liammchugh/HOPE_DECAL/COFFEE_MAKER/project submission files/HOPE Design Review Slides-Coffee Bean Roaster.pdf

# Coffee Bean Roaster

Carlson Jansen
Andrew Liu
Mirwais Lodin
Liam McHugh

## Project Overview and Name ~1 min

- Our project aims for implementing a functional precision temperature control for equipment like a Coffee Bean Roaster, by recycling simple popcorn maker with built in heater, fan, and AC power distribution.
- The project will dive into recreating thermocouple module, AC or DC heat fan dimmer/control board, wall plug AC/DC converter, additional app/GUI control on screen display.
- Major challenges would be precise feedback control of temperature in the chamber, additional serial peripheral interface bus may be required if multiple thermocouple is desired.
- ESP32, K-Type Thermocouple, 16x4 LCD
- Overall circuit designs (filter types, power regulator type, power source, microcontroller used, important sensors, actuators or ICs, data buses used)

## BOM ~30 sec

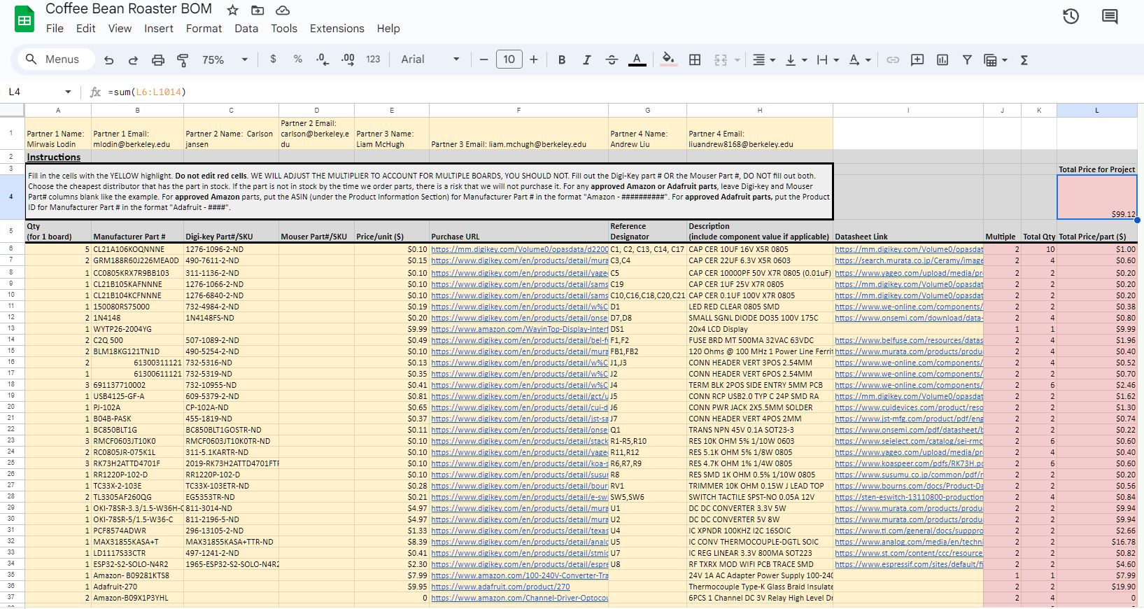
[picture p1: figure]

## Schematic ~2 min

TEMPLATE

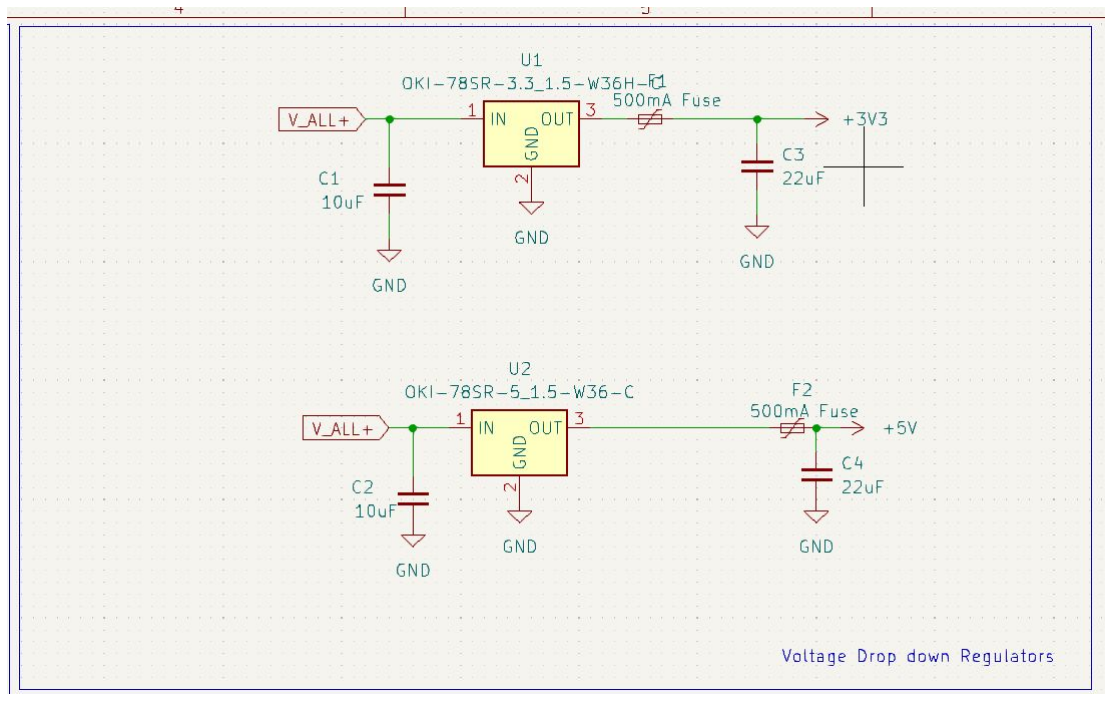
[picture p2: figure]

Voltage drop down module:
DC-DC Converters

24V to 3.3V
24V to 5V

## Schematic ~2 min

TEMPLATE

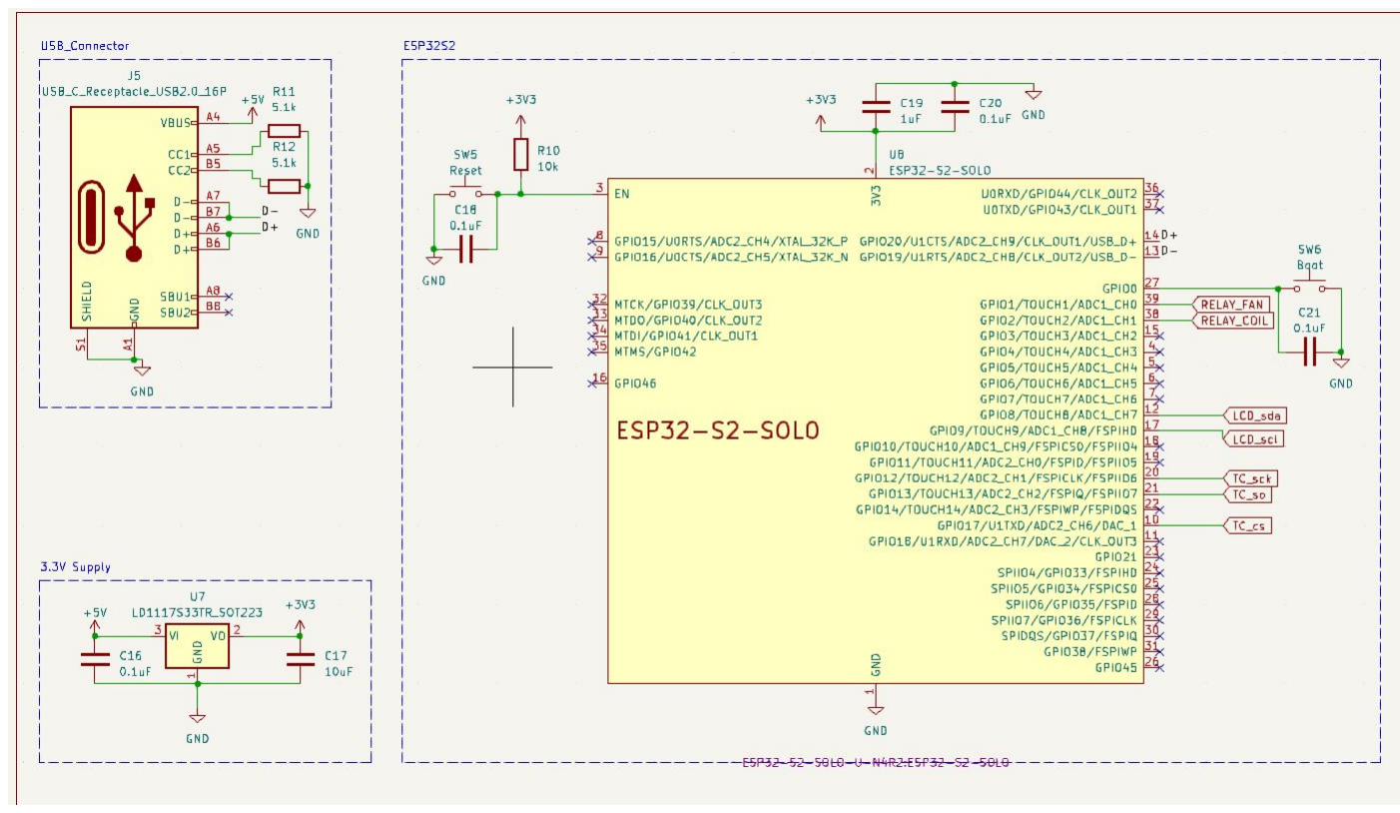
[picture p3: figure]

USB C receptacle

USB Voltage drop down:
-LDO linear Regulator

ESP32-S2-SOLO:
assigned GPIO:
-thermocouple: SO, SCK,CS
-LCD I2C: sda,scl
-Fan relay
-Heater relay
-Boot button
-Reset button

## Schematic ~2 min

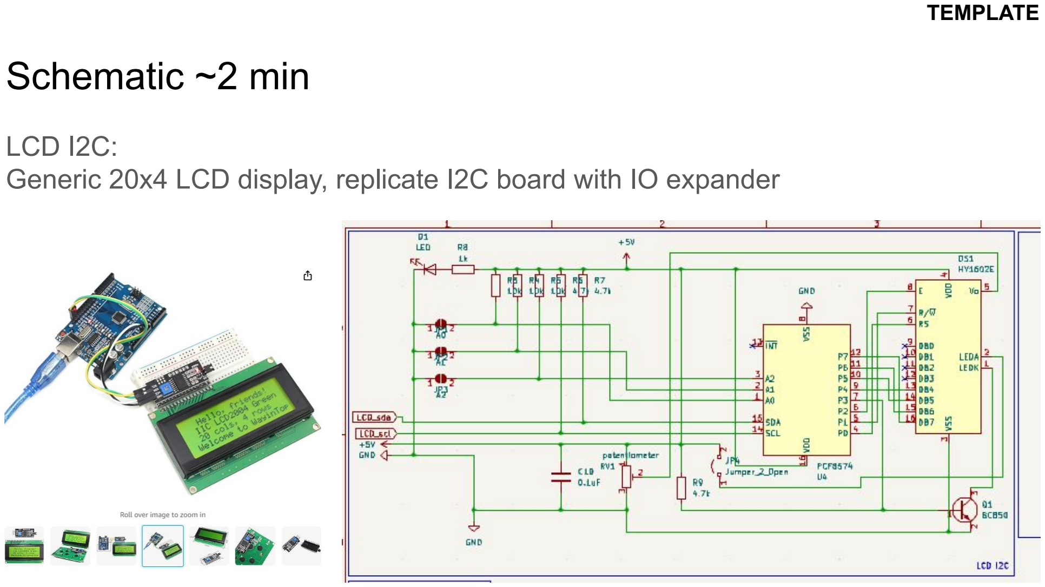
[picture p4: page 6]

TEMPLATE

LCD I2C:
Generic 20x4 LCD display, replicate I2C board with IO expander

## Schematic ~2 min

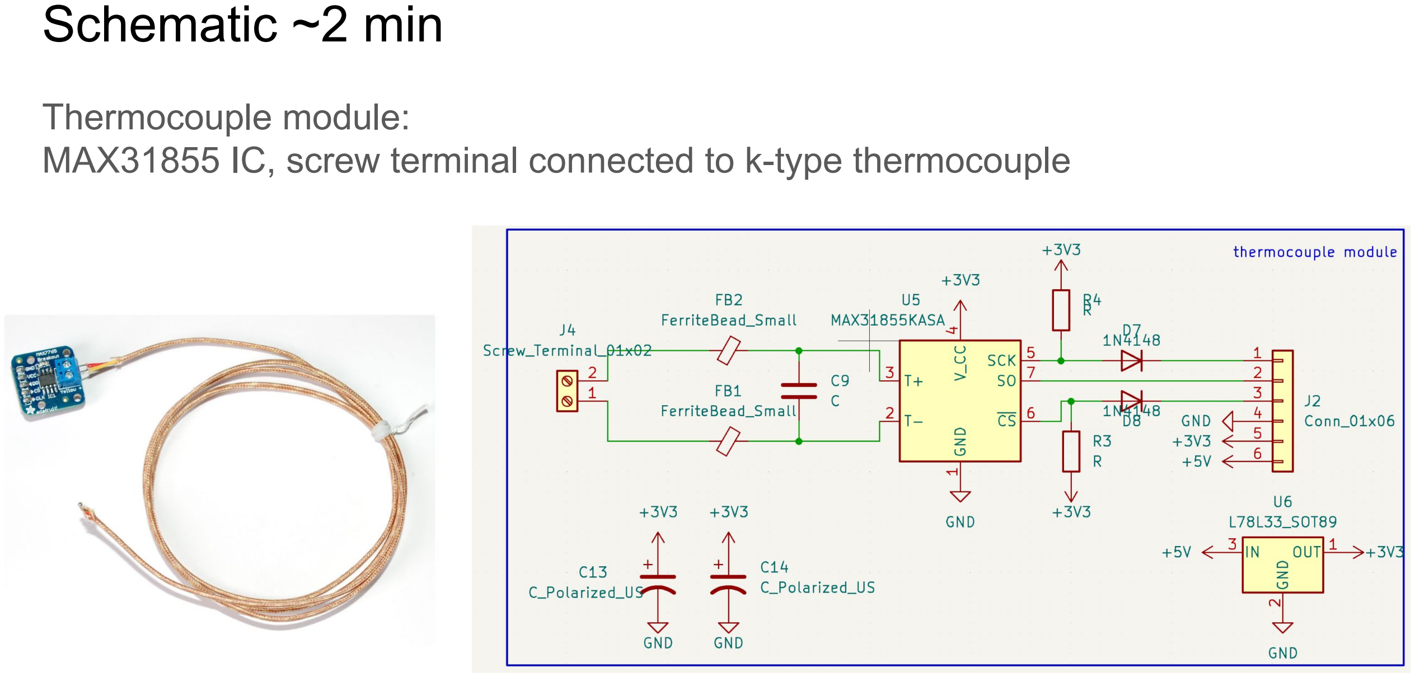
[picture p5: page 7]

Thermocouple module:
MAX31855 IC, screw terminal connected to k-type thermocouple

## Schematic ~2 min

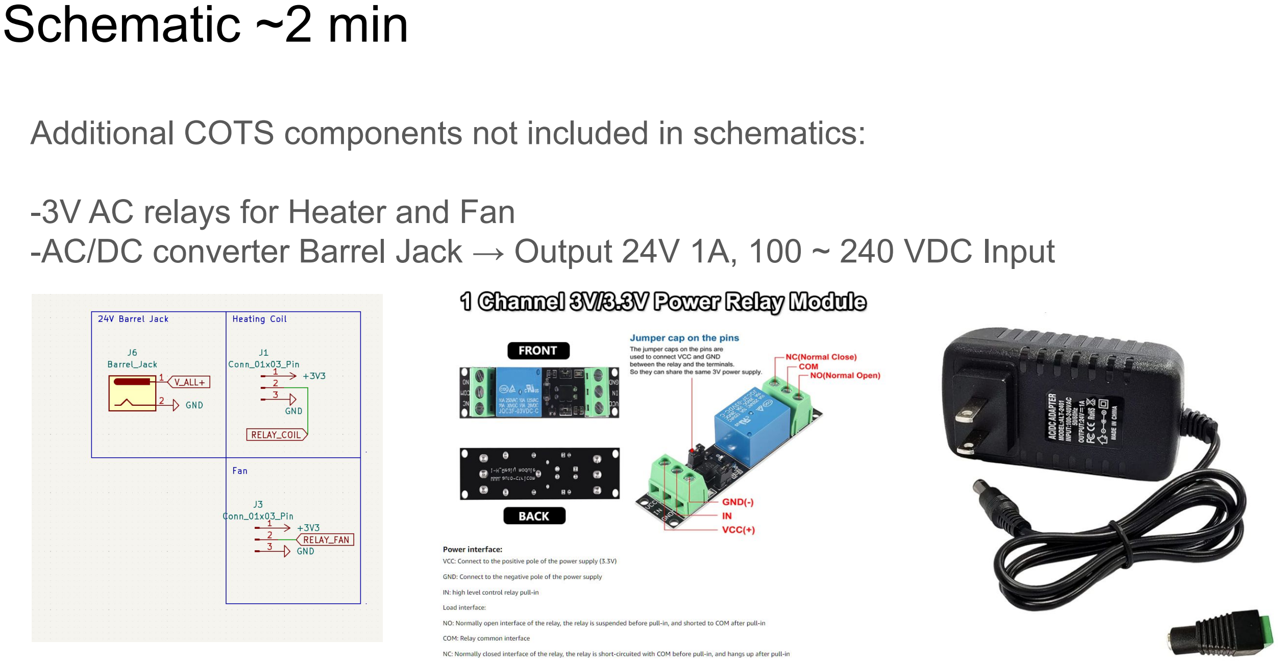
[picture p6: page 8]

Additional COTS components not included in schematics:

-3V AC relays for Heater and Fan
-AC/DC converter Barrel Jack → Output 24V 1A, 100 ~ 240 VDC Input

## Trace Widths

24V 1A DC input:
32 mil trace width, 32 mil via inner diameter, 64 mil via outer diameter:

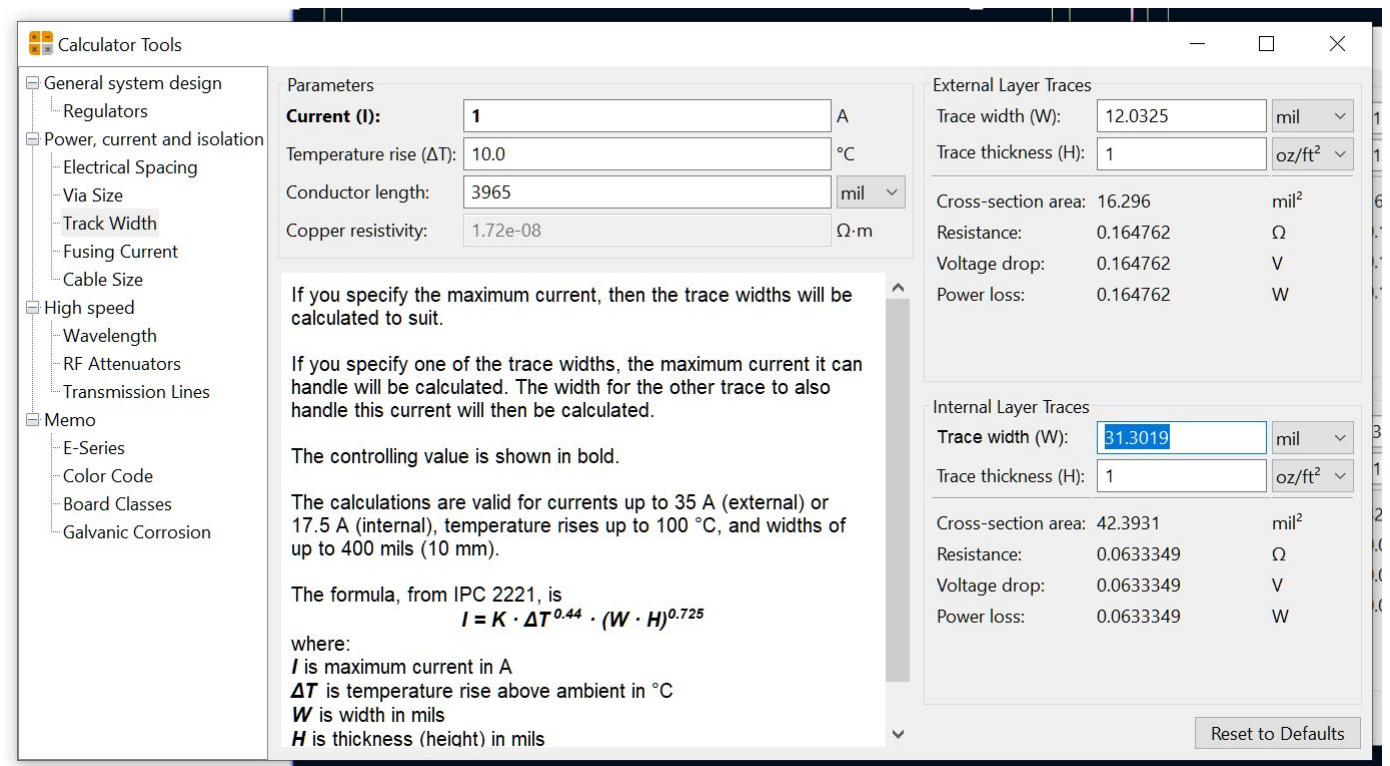
[picture p7: figure]

## Trace Widths

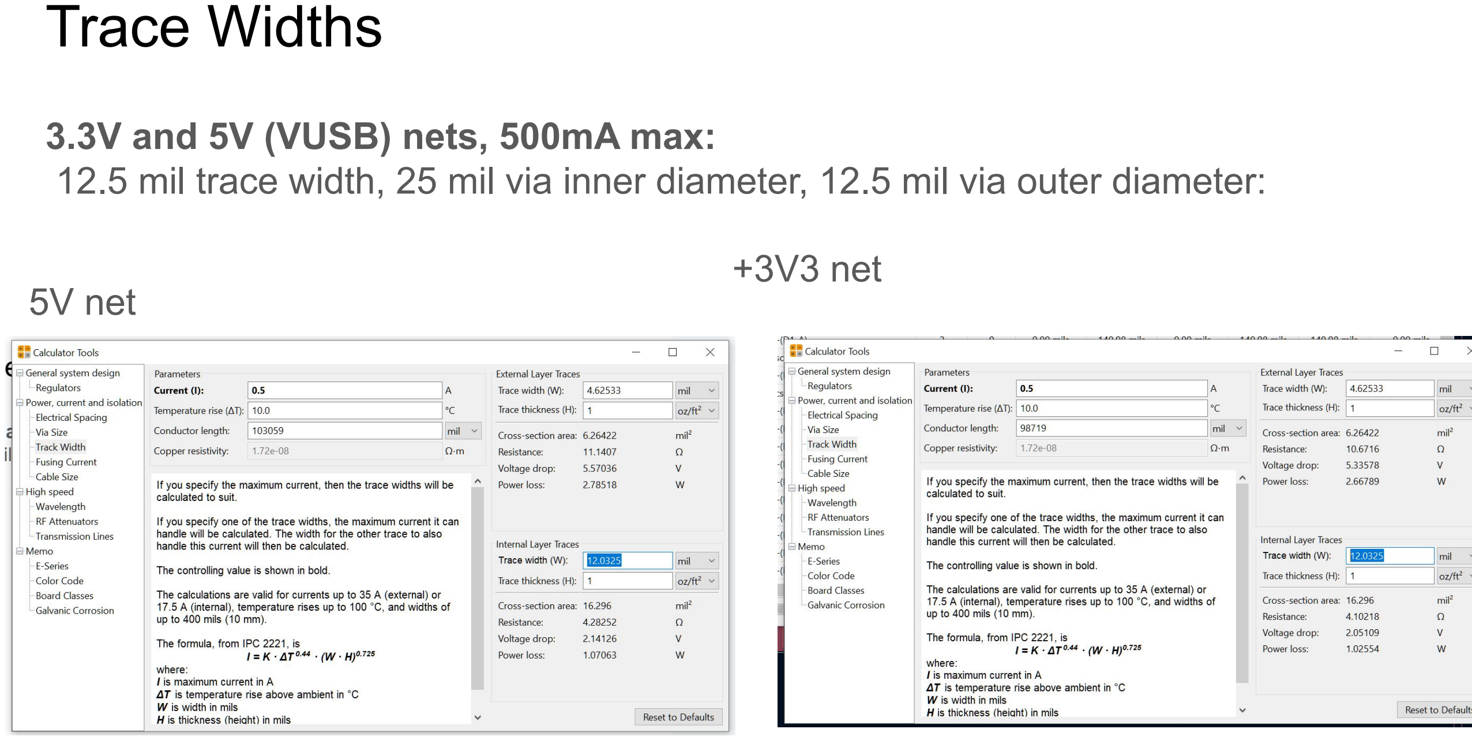
[picture p8: page 10]

3.3V and 5V (VUSB) nets, 500mA max:
12.5 mil trace width, 25 mil via inner diameter, 12.5 mil via outer diameter:

5V net

+3V3 net

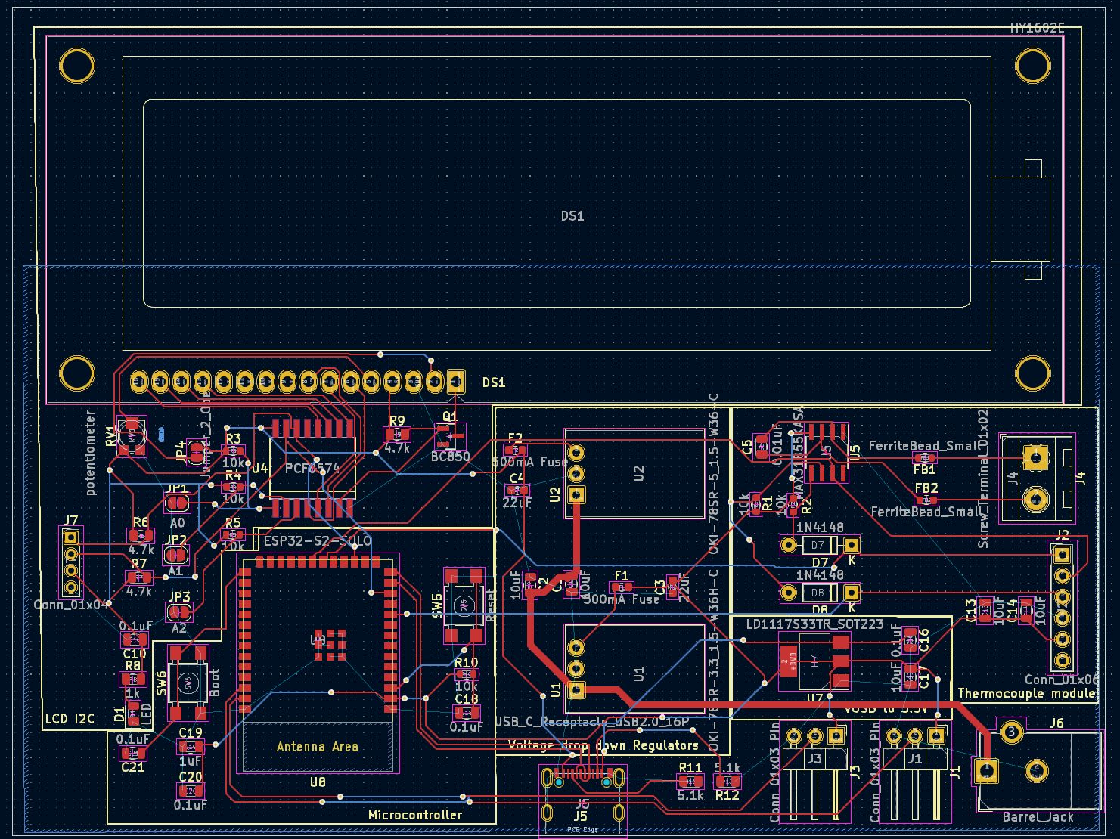
[picture p9: page 11]
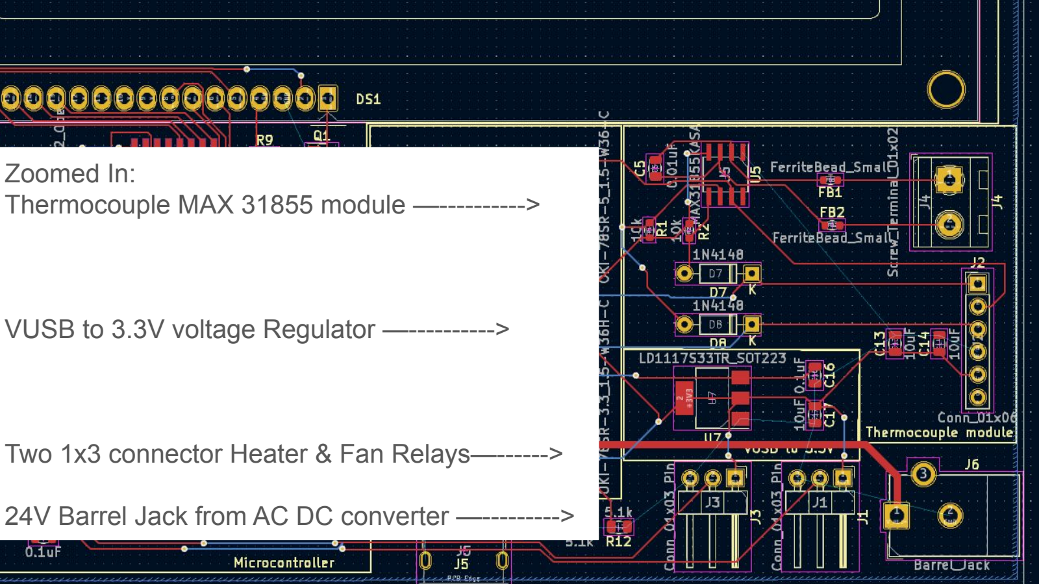
[picture p10: page 12]

Zoomed In:
Thermocouple MAX 31855 module —---------->

VUSB to 3.3V voltage Regulator —---------->

Two 1x3 connector Heater & Fan Relays—------>

24V Barrel Jack from AC DC converter —--------->

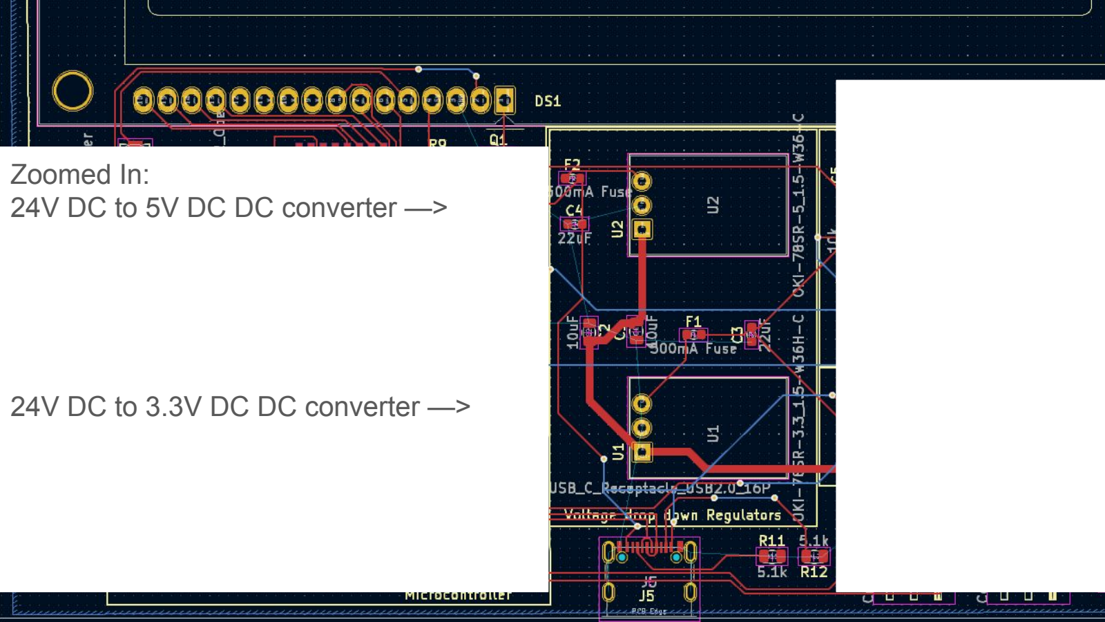
[picture p11: page 13]

Zoomed In:
24V DC to 5V DC DC converter —>

24V DC to 3.3V DC DC converter —>

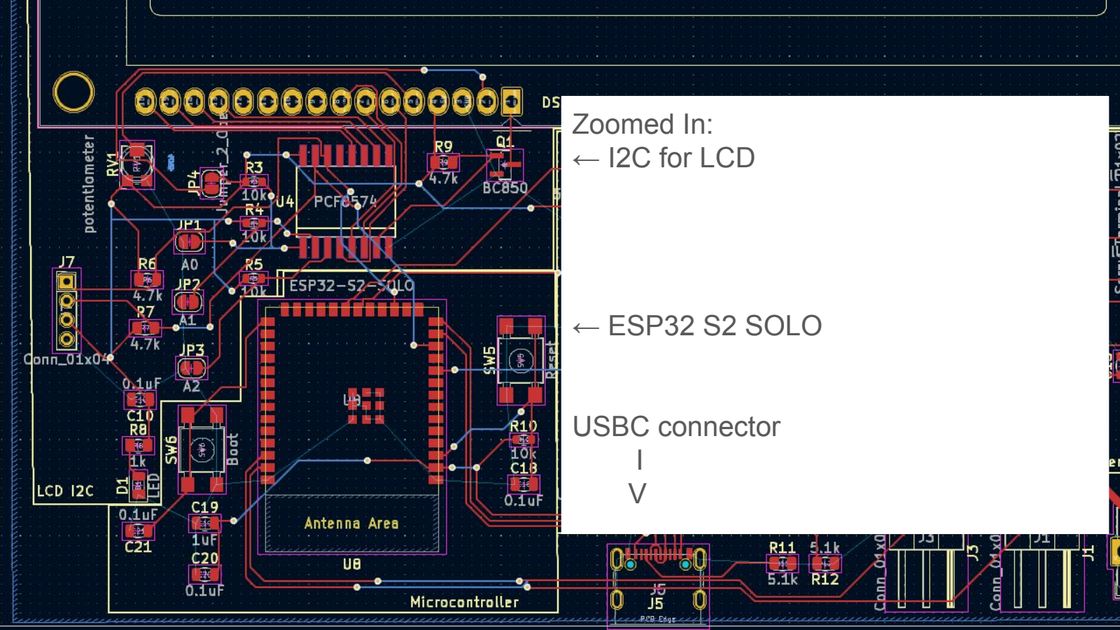
[picture p12: page 14]

Zoomed In:
← I2C for LCD

← ESP32 S2 SOLO

USBC connector
I
V

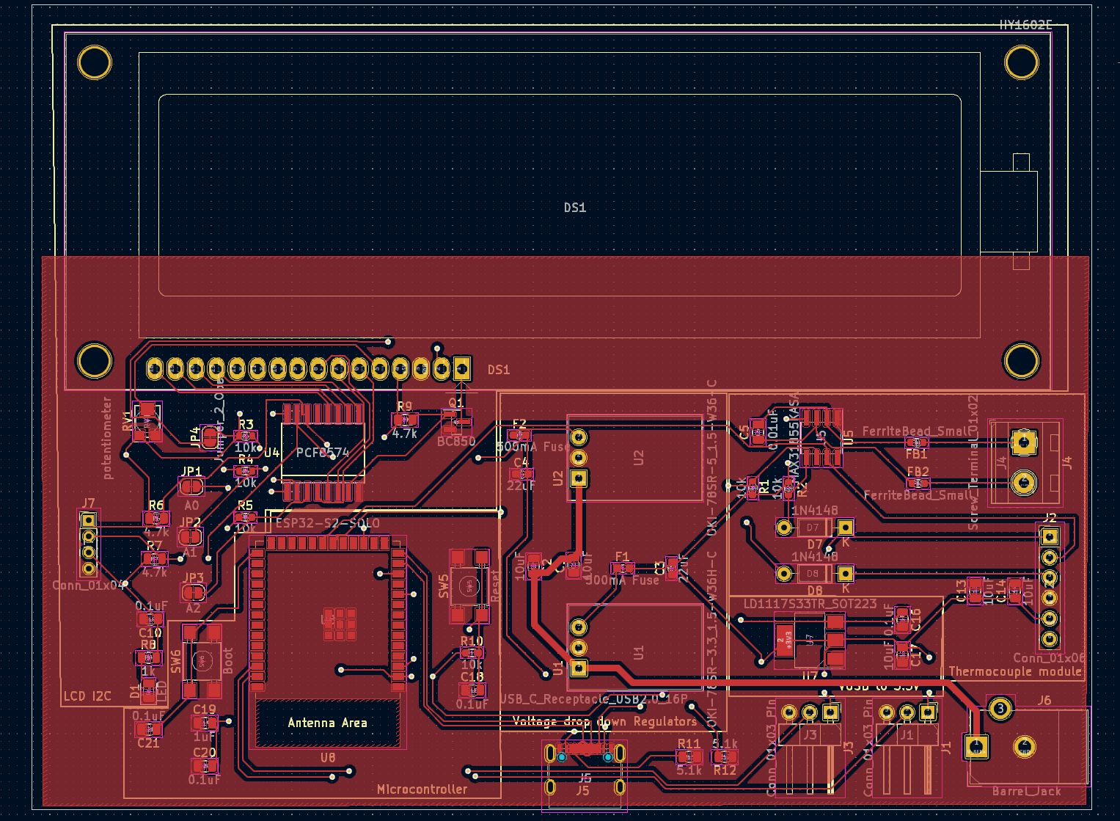
[picture p13: page 15]
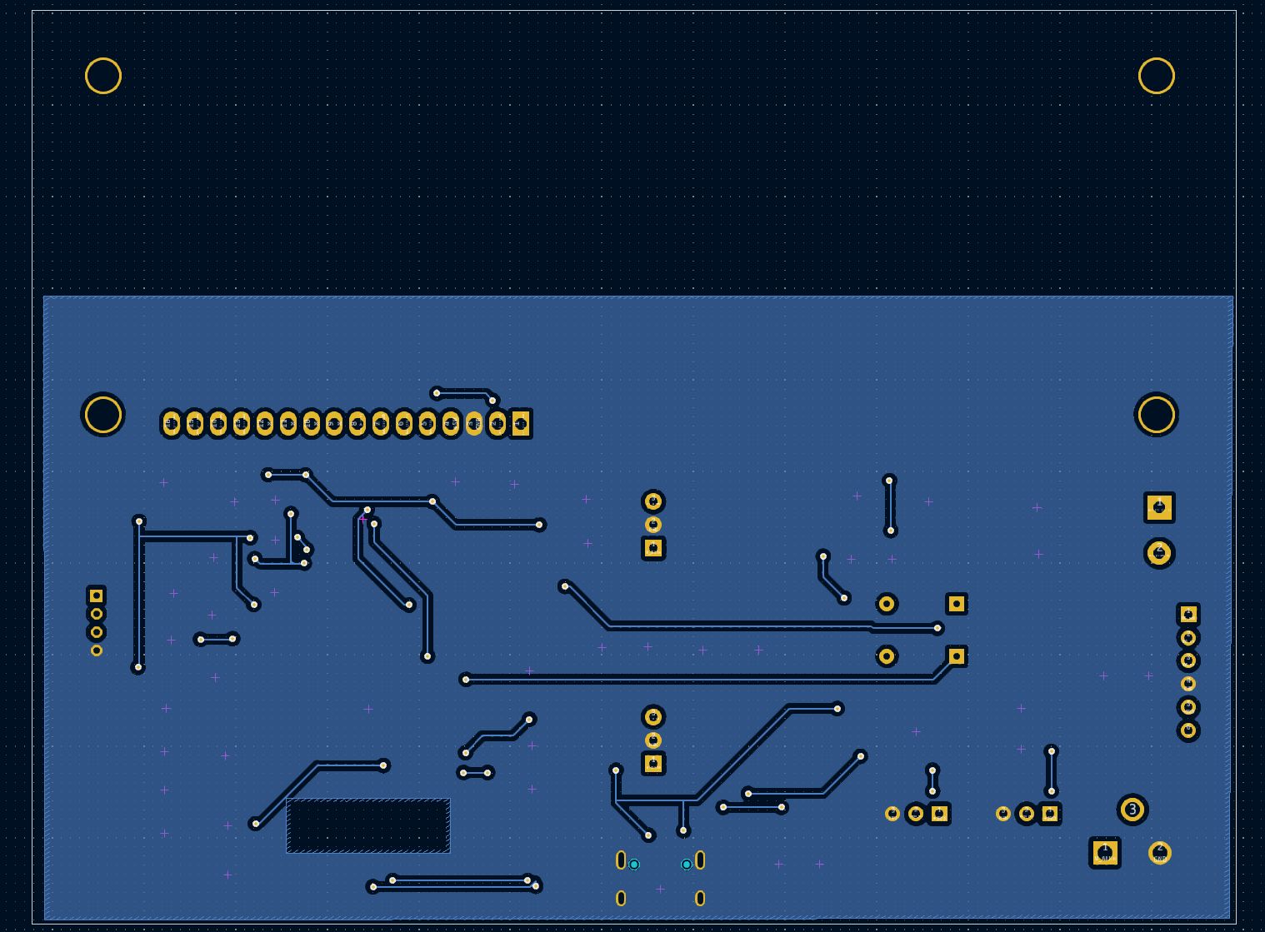
[picture p14: page 16]
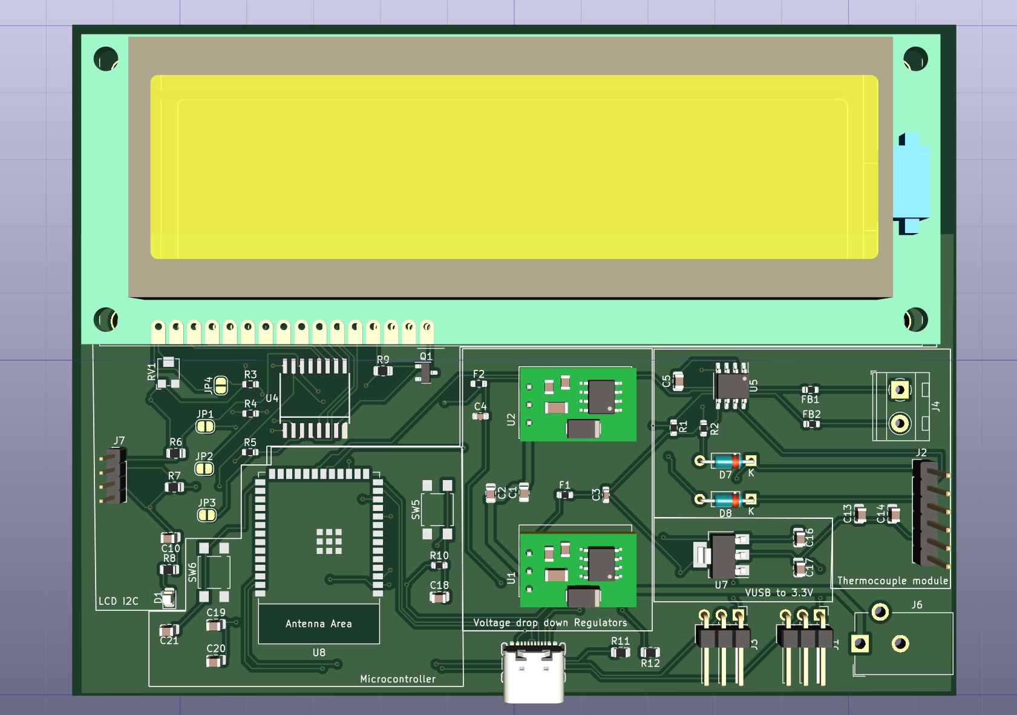
[picture p15: page 17]
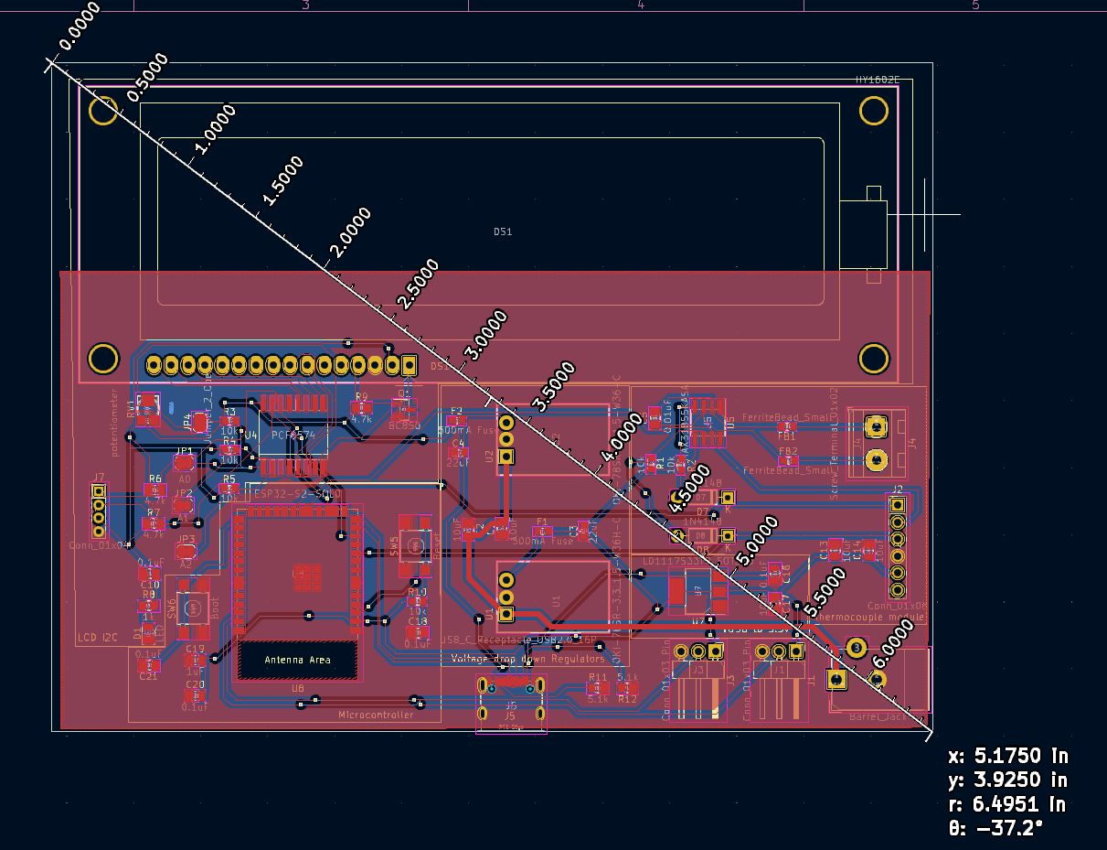
[picture p16: page 18]
