liammchugh/HOPE_DECAL/ESP32-S2-SOLO-U-N4R2/ESP32-S2-SOLO-U-N4R2.step

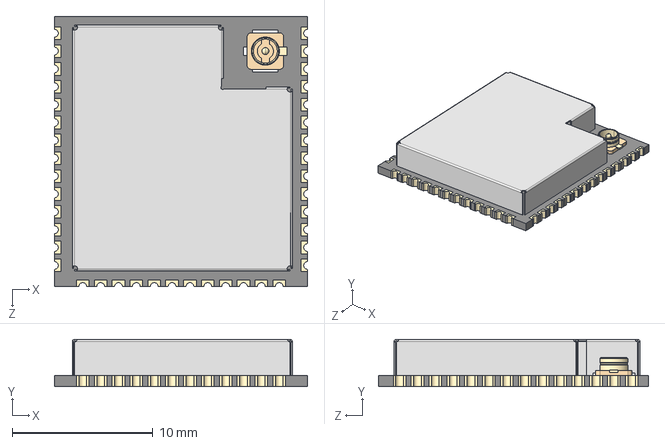
[picture p17: CAD file, 2024-04-05]
ESP32-S2-SOLO-U-N4R2/ESP32-S2-SOLO-U-N4R2.step
18.0 x 3.35 x 19.2 mm
