liammchugh/HOPE_DECAL/PCF8574/PCF8574.step

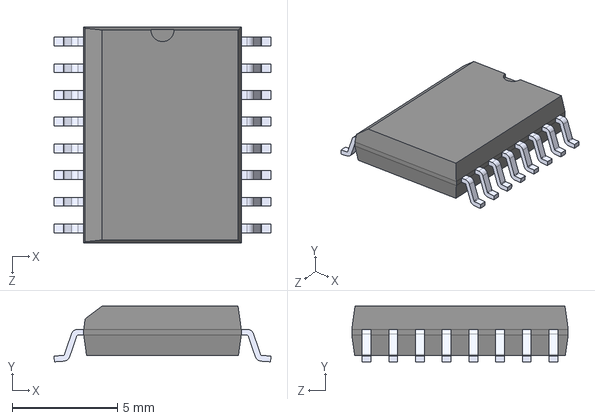
[picture p18: CAD file, 2024-04-05]
PCF8574/PCF8574.step
10.3 x 2.65 x 10.3 mm
