liammchugh/HOPE_DECAL/COFFEE_MAKER/COFFEE_MAKER.kicad_pcb

## KiCad design COFFEE_MAKER/COFFEE_MAKER.kicad_pcb (2024-04-11)

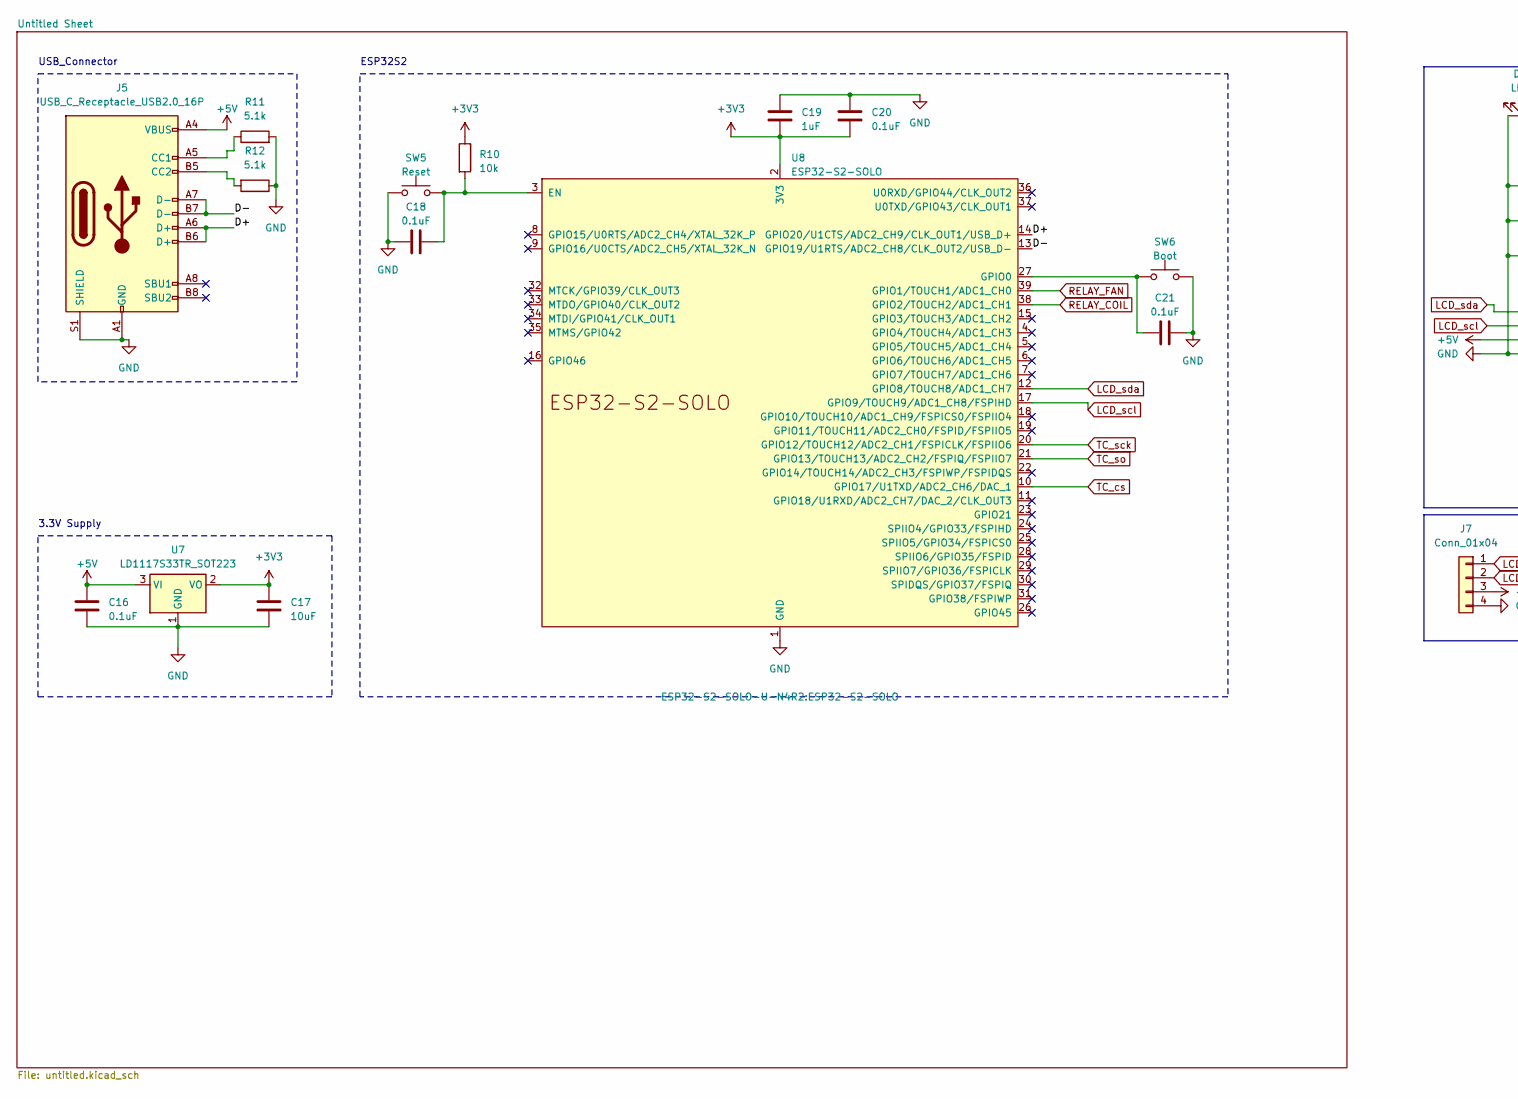
[picture p19: schematic COFFEE_MAKER.kicad_sch, part in row 1, column 1]

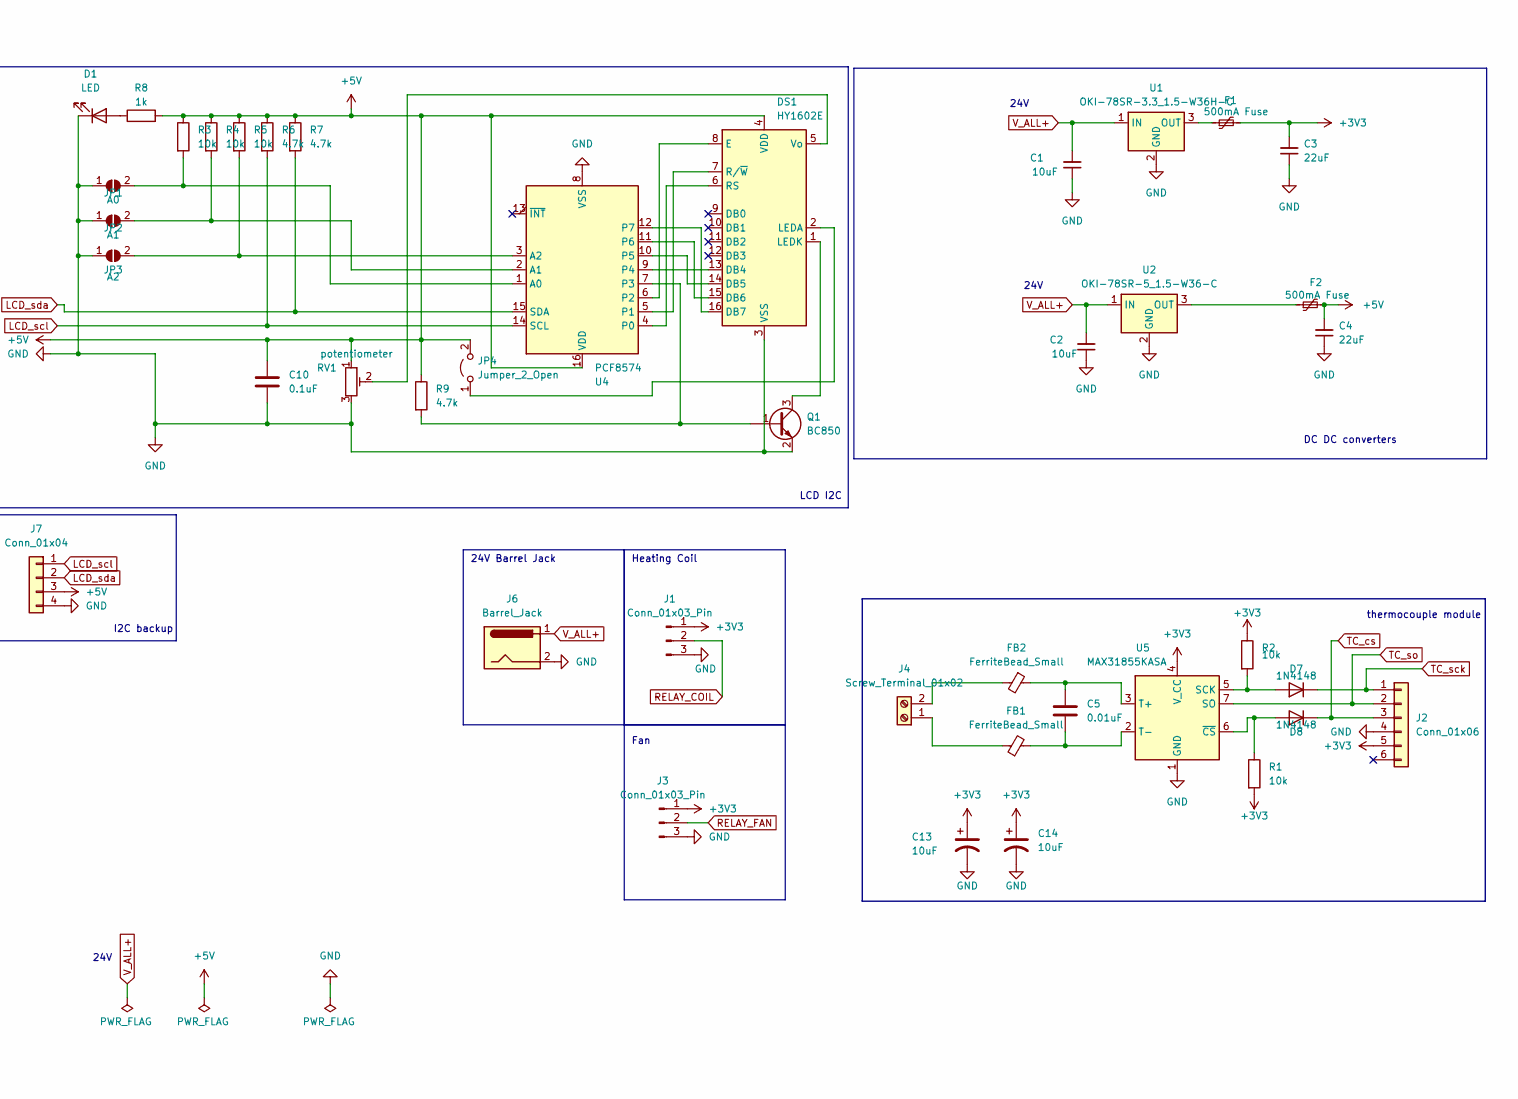
[picture p20: schematic COFFEE_MAKER.kicad_sch, part in row 1, column 2]

Parts:
C1, C2, C13, C14, C17: 10uF; C_0805_2012Metric
C3, C4: 22uF; C_0603_1608Metric
C5: 0.01uF; C_0805_2012Metric
C10, C16, C18, C20, C21: 0.1uF; C_0805_2012Metric
C19: 1uF; C_0805_2012Metric
D1: LED; LED_0805_2012Metric
D7, D8: 1N4148; D_DO-35_SOD27_P7.62mm_Horizontal
DS1: HY1602E
F1, F2: 500mA Fuse; Fuse_0603_1608Metric
FB1, FB2: FerriteBead_Small; R_0603_1608Metric
J1, J3: Conn_01x03_Pin; PinHeader_1x03_P2.54mm_Horizontal
J2: Conn_01x06; PinHeader_1x06_P2.54mm_Vertical
J4: Screw_Terminal_01x02; TerminalBlock_MetzConnect_Type094_RT03502HBLU_1x02_P5.00mm_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
J5: USB_C_Receptacle_USB2.0_16P; USB_C_Receptacle_GCT_USB4105-xx-A_16P_TopMnt_Horizontal
J6: Barrel_Jack; BarrelJack_CUI_PJ-102AH_Horizontal
J7: Conn_01x04; PinHeader_1x04_P2.00mm_Vertical
JP1: A0; SolderJumper-2_P1.3mm_Open_RoundedPad1.0x1.5mm
JP2: A1; SolderJumper-2_P1.3mm_Open_RoundedPad1.0x1.5mm
JP3: A2; SolderJumper-2_P1.3mm_Open_RoundedPad1.0x1.5mm
JP4: Jumper_2_Open; SolderJumper-2_P1.3mm_Open_RoundedPad1.0x1.5mm
Q1: BC850; SOT-23
R1, R2, R3, R4, R5, R10: 10k; R_0603_1608Metric
R6, R7, R9: 4.7k; R_0805_2012Metric
R8: 1k; R_0805_2012Metric
R11, R12: 5.1k; R_0805_2012Metric
RV1: potentiometer; Potentiometer_Bourns_TC33X_Vertical
SW5: Reset; SW_SPST_TL3305A
SW6: Boot; SW_SPST_TL3305A
U1: OKI-78SR-3.3_1.5-W36H-C; Converter_DCDC_Murata_OKI-78SR_Horizontal
U2: OKI-78SR-5_1.5-W36-C; Converter_DCDC_Murata_OKI-78SR_Horizontal
U4: PCF8574; SOIC16R
U5: MAX31855KASA; SOIC-8_3.9x4.9mm_P1.27mm
U7: LD1117S33TR_SOT223; SOT-223-3_TabPin2
U8: ESP32-S2-SOLO

Connections:
+3V3: C3.2, C13.1, C14.1, C17.1, C19.2, C20.2, F1.2, J1.1, J2.5, J3.1, R1.2, R2.1, R10.1, U5.4 (V_CC), U7.2 (VO), U8.2 (3V3)
+5V: C4.2, C10.1, C16.1, DS1.4 (VDD), F2.2, J5.A4 (VBUS), J5.A9 (VBUS), J5.B4 (VBUS), J5.B9 (VBUS), J7.3, JP4.2 (B), R3.1, R4.1, R5.1, R6.1, R7.1, R8.2, R9.1, RV1.1, U4.16 (VDD), U7.3 (VI)
/D+: J5.A6 (D+), J5.B6 (D+), U8.14 (GPIO20/U1CTS/ADC2_CH9/CLK_OUT1/USB_D+)
/D-: J5.A7 (D-), J5.B7 (D-), U8.13 (GPIO19/U1RTS/ADC2_CH8/CLK_OUT2/USB_D-)
GND: C1.1, C2.1, C3.1, C4.1, C10.2, C13.2, C14.2, C16.2, C17.2, C18.1, C19.1, C20.1, C21.2, D1.1 (K), DS1.3 (VSS), J1.3, J2.4, J3.3, J5.A1 (GND), J5.A12 (GND), J5.B1 (GND), J5.B12 (GND), J5.S1 (SHIELD), J6.2, J7.4, JP1.1 (A), JP2.1 (A), JP3.1 (A), Q1.2 (E), R11.2, R12.1, RV1.3, SW5.1, SW6.2, U1.2 (GND), U2.2 (GND), U4.8 (VSS), U5.1 (GND), U7.1 (GND), U8.1 (GND), U8.40 (GND), U8.41 (GND)
LCD_scl: J7.1, R6.2, U4.14 (SCL), U8.17 (GPIO9/TOUCH9/ADC1_CH8/FSPIHD)
LCD_sda: J7.2, R7.2, U4.15 (SDA), U8.12 (GPIO8/TOUCH8/ADC1_CH7)
unnamed: D1.2 (A), R8.1
unnamed: D7.2 (A), R2.2, U5.5 (SCK)
unnamed: D8.2 (A), R1.1, U5.6 (~CS)
unnamed: DS1.13 (DB4), U4.9 (P4)
unnamed: DS1.14 (DB5), U4.10 (P5)
unnamed: DS1.15 (DB6), U4.11 (P6)
unnamed: DS1.16 (DB7), U4.12 (P7)
unnamed: DS1.8 (E), U4.6 (P2)
unnamed: DS1.2 (LEDA), JP4.1 (A)
unnamed: DS1.1 (LEDK), Q1.3 (C)
unnamed: DS1.6 (RS), U4.4 (P0)
unnamed: DS1.7 (R/~W), U4.5 (P1)
unnamed: DS1.5 (Vo), RV1.2
unnamed: FB1.1, J4.1
unnamed: FB2.2, J4.2
unnamed: J5.A5 (CC1), R11.1
unnamed: J5.B5 (CC2), R12.2
unnamed: JP1.2 (B), R3.2, U4.1 (A0)
unnamed: JP2.2 (B), R4.2, U4.2 (A1)
unnamed: JP3.2 (B), R5.2, U4.3 (A2)
unnamed: Q1.1 (B), R9.2, U4.7 (P3)
unnamed: F1.1, U1.3 (OUT)
unnamed: F2.1, U2.3 (OUT)
unnamed: C5.1, FB2.1, U5.3 (T+)
unnamed: C5.2, FB1.2, U5.2 (T-)
unnamed: C18.2, R10.2, SW5.2, U8.3 (EN)
unnamed: C21.1, SW6.1, U8.27 (GPIO0)
RELAY_COIL: J1.2, U8.38 (GPIO2/TOUCH2/ADC1_CH1)
RELAY_FAN: J3.2, U8.39 (GPIO1/TOUCH1/ADC1_CH0)
TC_cs: D8.1 (K), J2.3, U8.10 (GPIO17/U1TXD/ADC2_CH6/DAC_1)
TC_sck: D7.1 (K), J2.1, U8.20 (GPIO12/TOUCH12/ADC2_CH1/FSPICLK/FSPIIO6)
TC_so: J2.2, U5.7 (SO), U8.21 (GPIO13/TOUCH13/ADC2_CH2/FSPIQ/FSPIIO7)
V_ALL+: C1.2, C2.2, J6.1, U1.1 (IN), U2.1 (IN)

Notes on the sheet:
24V
Heating Coil
24V Barrel Jack
LCD I2C
I2C backup
DC DC converters
USB_Connector
thermocouple module
3.3V Supply
Fan
ESP32S2

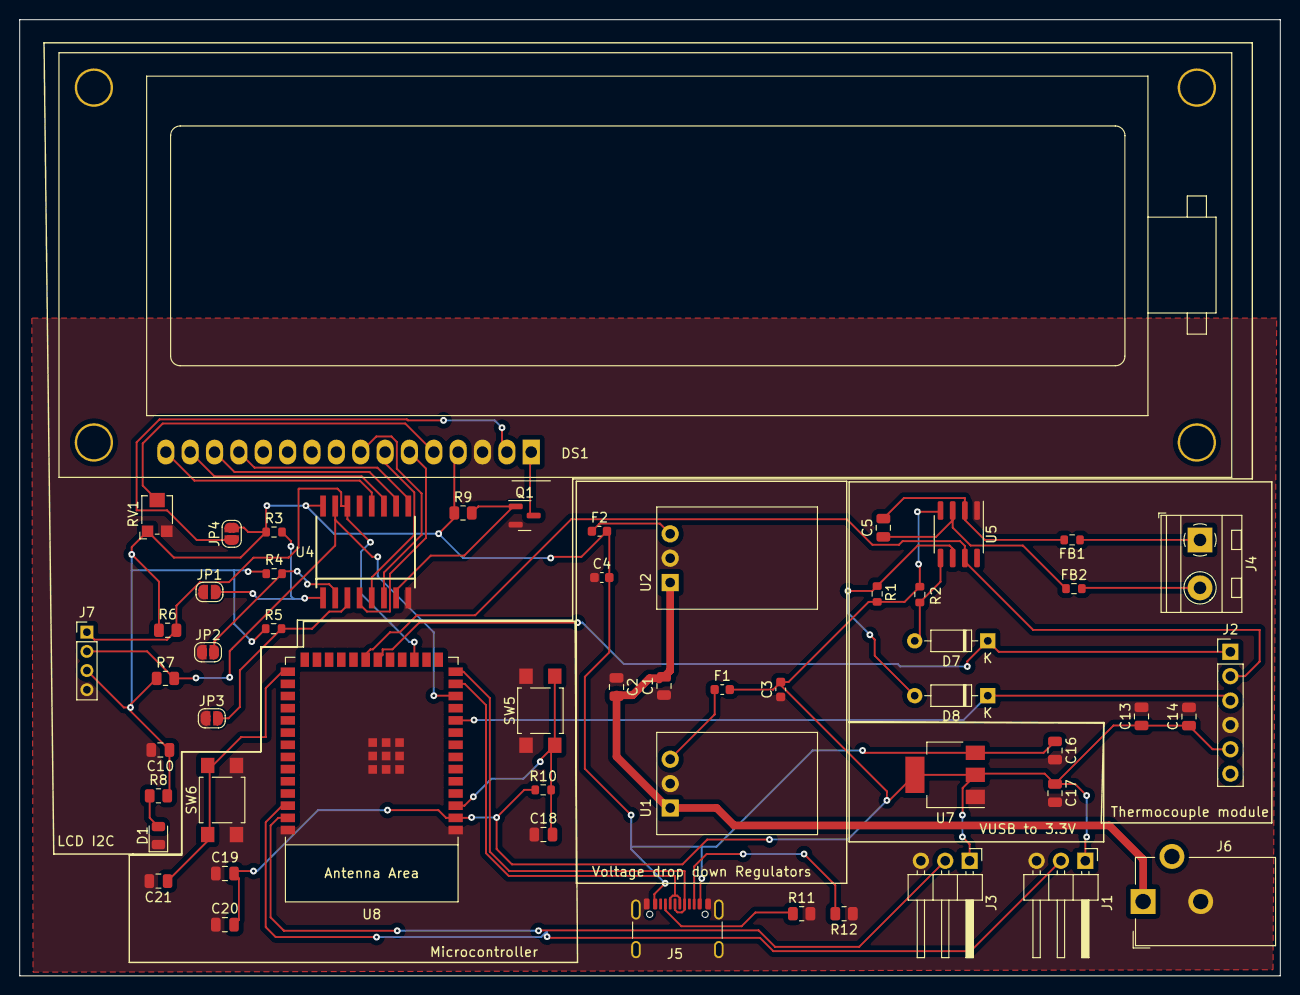
[picture p21: board COFFEE_MAKER.kicad_pcb from above]

Board: 2 copper layers, 131.4 x 99.7 mm, 55 parts (0 on the bottom side), 40 nets.
