liammchugh/HOPE_DECAL/(commit log)

2024-03-14 setup and breakout
    [COFFEE_MAKER.kicad_pcb, COFFEE_MAKER.kicad_sch, ESP32-Breakout.kicad_sch]
2024-03-14 update accuracy
    [ESP32-Breakout.kicad_sch]
2024-04-03 updated schematics
    [COFFEE_MAKER.kicad_sch]
2024-04-03 schemativs update
    [untitled.kicad_sch]
2024-04-04 schematics update
    [COFFEE_MAKER.kicad_sch]
2024-04-04 schematic update
    [COFFEE_MAKER.kicad_sch]
2024-04-04 added backup i2c pin, change lcd voltage to 5v
    [COFFEE_MAKER.kicad_sch]
2024-04-04 added connector for pin
    [COFFEE_MAKER.kicad_sch]
2024-04-04 relay pcb folder
    [RELAY_PCB.kicad_pcb, RELAY_PCB.kicad_sch]
2024-04-05 schematic footprints assigned
    [COFFEE_MAKER.kicad_sch, ESP32-Breakout.kicad_sch]
2024-04-05 schematics done (custom footprint PCF8574 and ESP32-S2-N4)
    [COFFEE_MAKER.kicad_sch, ESP32-S2-SOLO-U-N4R2.step, PCF8574.step]
2024-04-07 update esp32 footprint, layout wip
    [COFFEE_MAKER.kicad_pcb, COFFEE_MAKER.kicad_sch]
2024-04-07 board layout wip 27 errors
    [COFFEE_MAKER.kicad_pcb, COFFEE_MAKER.kicad_sch]
2024-04-09 layout done, saved copy of slides
    .Layout done, slides saved as ppt and pdf in folder, google slides here:
    https://docs.google.com/presentation/d/1jqAALReZK5NcbOIQpBx0YGVnQ22f8MZOJf6NqvKvuig/edit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
    [COFFEE_MAKER.kicad_pcb, COFFEE_MAKER.kicad_sch, HOPE_template.kicad_pcb, HOPE_template.kicad_sch]
2024-04-09 layout mask to silkscreen fix
    [COFFEE_MAKER-B_Cu.gbr, COFFEE_MAKER-B_Mask.gbr, COFFEE_MAKER-B_Paste.gbr, COFFEE_MAKER-B_Silkscreen.gbr, COFFEE_MAKER-Edge_Cuts.gbr, COFFEE_MAKER-F_Cu.gbr, COFFEE_MAKER-F_Mask.gbr, COFFEE_MAKER-F_Paste.gbr]
2024-04-09 schematic bom wip
    [COFFEE_MAKER-B_Cu.gbr, COFFEE_MAKER-B_Mask.gbr, COFFEE_MAKER-B_Paste.gbr, COFFEE_MAKER-B_Silkscreen.gbr, COFFEE_MAKER-Edge_Cuts.gbr, COFFEE_MAKER-F_Cu.gbr, COFFEE_MAKER-F_Mask.gbr, COFFEE_MAKER-F_Paste.gbr]
2024-04-11 layout v1 done, slides, BOM, manufacturing folder ready
    [COFFEE_MAKER-B_Cu.gbr, COFFEE_MAKER-B_Mask.gbr, COFFEE_MAKER-B_Paste.gbr, COFFEE_MAKER-B_Silkscreen.gbr, COFFEE_MAKER-Edge_Cuts.gbr, COFFEE_MAKER-F_Cu.gbr, COFFEE_MAKER-F_Mask.gbr, COFFEE_MAKER-F_Paste.gbr]
2024-04-11 pcb finalized, manufacturing folder finalized, BOM& slides in submission folder finalized
    [COFFEE_MAKER-B_Cu.gbr, COFFEE_MAKER-B_Mask.gbr, COFFEE_MAKER-B_Paste.gbr, COFFEE_MAKER-B_Silkscreen.gbr, COFFEE_MAKER-Edge_Cuts.gbr, COFFEE_MAKER-F_Cu.gbr, COFFEE_MAKER-F_Mask.gbr, COFFEE_MAKER-F_Paste.gbr]
